huseyinTozluyurt/Indoor-Autonomous-Robot-for-Delivery/Embedded Software /Robot Distance Perception/main.c

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
/* Includes ------------------------------------------------------------------*/
#include "main.h"

/* USER CODE BEGIN Includes */
#include "hcsr04.h"
#include <stdio.h>
#include <string.h>
/* USER CODE END Includes */

TIM_HandleTypeDef htim2;

UART_HandleTypeDef huart1;

/* USER CODE BEGIN PV */



#define SENSOR_COUNT 4

#define OBSTACLE_THRESHOLD_CM 20




HCSR04_Sensor hcsr04_sensors[SENSOR_COUNT] =
{
    /*
     * Front sensor
     * TRIG: PB0
     * ECHO: PA0
     */
    {GPIOB, GPIO_PIN_0,  GPIOA, GPIO_PIN_0,  0, HCSR04_TIMEOUT_ERROR},

    /*
     * Left sensor
     * TRIG: PB1
     * ECHO: PA1
     */
    {GPIOB, GPIO_PIN_1,  GPIOA, GPIO_PIN_1,  0, HCSR04_TIMEOUT_ERROR},

    /*
     * Right sensor
     * TRIG: PB10
     * ECHO: PA2
     */
    {GPIOB, GPIO_PIN_10, GPIOA, GPIO_PIN_2,  0, HCSR04_TIMEOUT_ERROR},

    /*
     * Back sensor
     * TRIG: PB11
     * ECHO: PA3
     */
    {GPIOB, GPIO_PIN_11, GPIOA, GPIO_PIN_3,  0, HCSR04_TIMEOUT_ERROR}
};




/* USER CODE END PV */

void SystemClock_Config(void);
static void MX_GPIO_Init(void);
static void MX_TIM2_Init(void);
static void MX_USART1_UART_Init(void);
/* USER CODE BEGIN 0 */



void Print_Sensor_Readings(void)
{
    char msg[200];

    snprintf(msg, sizeof(msg),
             "Front: %lu cm [%s] | Left: %lu cm [%s] | Right: %lu cm [%s] | Back: %lu cm [%s]\r\n",
             hcsr04_sensors[0].distance_cm,
             hcsr04_sensors[0].status == HCSR04_OK ? "OK" : "ERR",
             hcsr04_sensors[1].distance_cm,
             hcsr04_sensors[1].status == HCSR04_OK ? "OK" : "ERR",
             hcsr04_sensors[2].distance_cm,
             hcsr04_sensors[2].status == HCSR04_OK ? "OK" : "ERR",
             hcsr04_sensors[3].distance_cm,
             hcsr04_sensors[3].status == HCSR04_OK ? "OK" : "ERR");

    HAL_UART_Transmit(&huart1, (uint8_t*)msg, strlen(msg), HAL_MAX_DELAY);
}



void Send_Distance_Data_UART(void)
{
    char msg[160];

    /*
     * CSV format:
     * FRONT,LEFT,RIGHT,BACK,STATUS
     *
     * Example:
     * 35,42,28,999,1
     *
     * STATUS:
     * 0 = all sensors OK
     * 1 = at least one sensor error
     */

    uint8_t sensor_error = 0;

    for (uint8_t i = 0; i < SENSOR_COUNT; i++)
    {
        if (hcsr04_sensors[i].status != HCSR04_OK)
        {
            sensor_error = 1;
        }
    }

    snprintf(msg, sizeof(msg),
             "%lu,%lu,%lu,%lu,%u\n",
			 hcsr04_sensors[0].distance_cm,   // Front
             hcsr04_sensors[1].distance_cm,   // Left
             hcsr04_sensors[2].distance_cm,   // Right
             hcsr04_sensors[3].distance_cm,   // Back
             sensor_error);

    HAL_UART_Transmit(&huart1, (uint8_t*)msg, strlen(msg), HAL_MAX_DELAY);
}



/* USER CODE END 0 */

/**
  * @brief  The application entry point.
  * @retval int
  */
int main(void)
{

  /* MCU Configuration--------------------------------------------------------*/

  /* Reset of all peripherals, Initializes the Flash interface and the Systick. */
  HAL_Init();

  /* Configure the system clock */
  SystemClock_Config();

  /* Initialize all configured peripherals */
  MX_GPIO_Init();
  MX_TIM2_Init();
  MX_USART1_UART_Init();
  /* USER CODE BEGIN 2 */
  HCSR04_Init(&htim2);
  //Set_Binary_LEDs(0);
  /* USER CODE END 2 */

  /* Infinite loop */
  /* USER CODE BEGIN WHILE */
  while (1)
  {
    /* USER CODE END WHILE */


    /* USER CODE BEGIN 3 */


	  HCSR04_Read_All(hcsr04_sensors, SENSOR_COUNT);

	  Send_Distance_Data_UART();

	  HAL_Delay(300);

  }
  /* USER CODE END 3 */
}

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
