huseyinTozluyurt/Indoor-Autonomous-Robot-for-Delivery/(commit log)

2026-06-23 Add Arduino motor command control script
2026-11-11 Write project README
    Document the system architecture, hardware and pinouts, firmware
    behaviour, Raspberry Pi scripts, serial protocols, build/flash steps,
    calibration and troubleshooting.
    Claude-Session: https://claude.ai/code/session_01MyLQgRAvLYfV3miV3CXucX
2026-11-11 Add Arduino wiring diagram and STM32CubeIDE pinout to README
    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
