huseyinTozluyurt/Indoor-Autonomous-Robot-for-Delivery/(notices)

Notices in the files:
Embedded Software /Robot Distance Perception/main.c:
Copyright (c) 2026 STMicroelectronics.
All rights reserved.
This software is licensed under terms that can be found in the LICENSE file
